MatiasV98/brazo-robotico-6gdl/cad/README.md

# cad

Modelos 3D del proyecto.

## Contenido

| Archivo | Descripción |
|---|---|
| `carcasa_electronica.f3d` | Diseño de la caja (carcasa) que protege la electrónica del brazo. |

La carcasa se imprimió en 3D en **PLA**, en una impresora Bambu Lab A1 del Laboratorio de Técnicas Digitales III. Una imagen del diseño está en [`docs/img/carcasa.jpg`](../docs/img/carcasa.jpg).

El archivo es un proyecto de **Autodesk Fusion 360** (`.f3d`). Para abrirlo: en Fusion 360, *Archivo → Abrir → Abrir desde mi equipo* y seleccionar el archivo.
