MatiasV98/brazo-robotico-6gdl/(list of files, cad)

Other CAD files:
cad/carcasa_electronica.f3d
