MatiasV98/brazo-robotico-6gdl/hardware/kicad/Placa Definitiva-Proyecto Brazo Robotico.kicad_pcb

## KiCad design hardware/kicad/Placa Definitiva-Proyecto Brazo Robotico.kicad_pcb (2026-11-07)

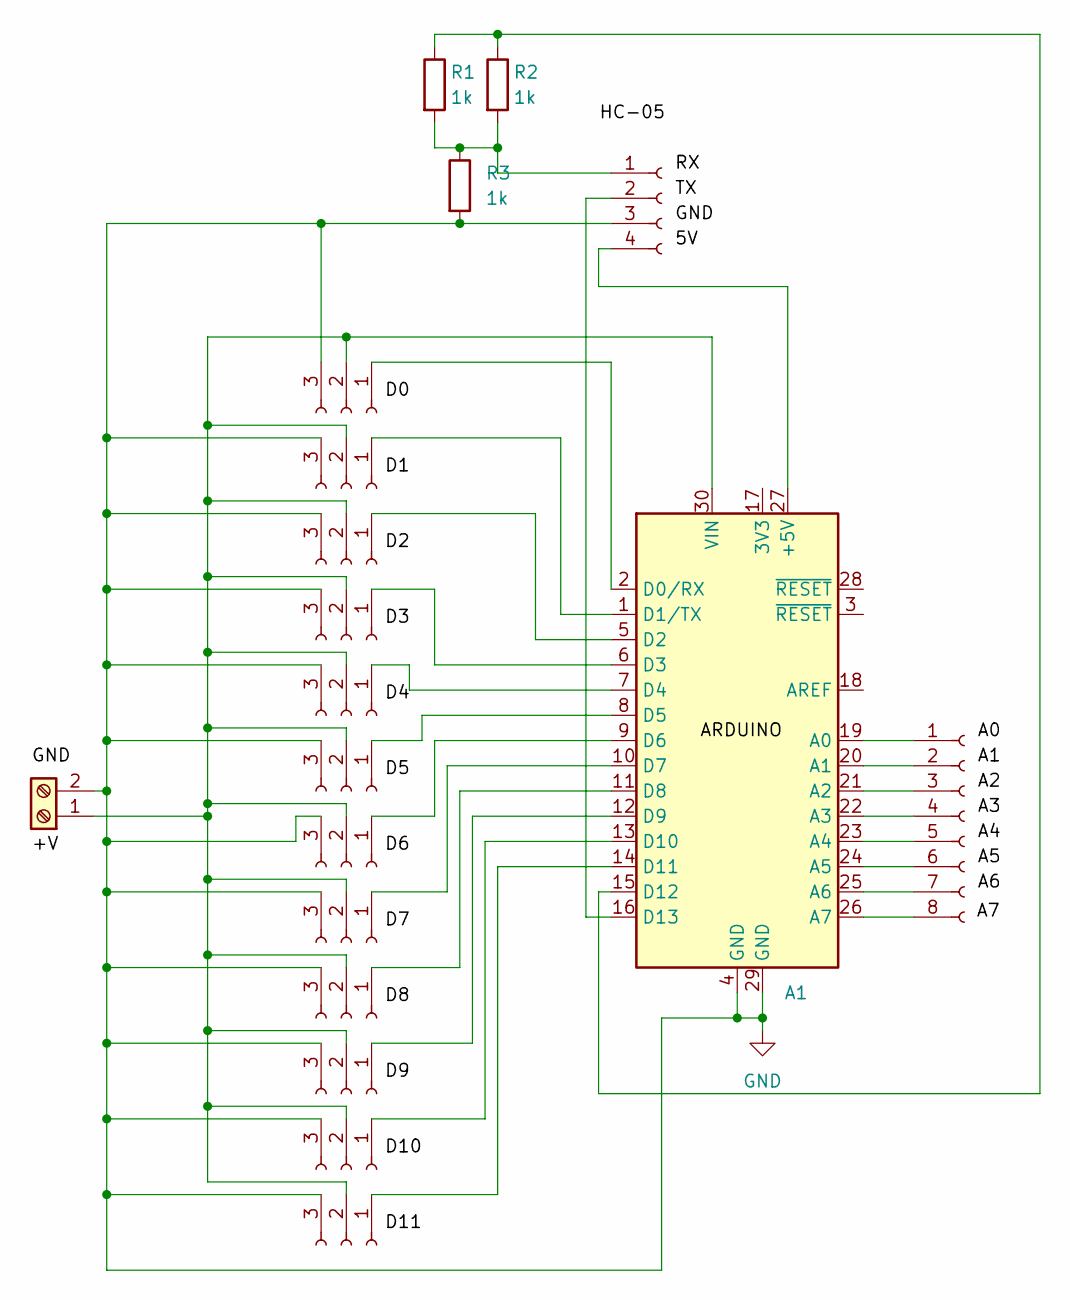
[picture p8: schematic Placa Definitiva-Proyecto Brazo Robotico.kicad_sch]

Parts:
A1: Arduino_Nano_v2.x; Arduino_Nano
J1: Screw_Terminal_01x02; TerminalBlock_MaiXu_MX126-5.0-02P_1x02_P5.00mm
J2: Conn_01x04_Socket; PinSocket_1x04_P2.54mm_Vertical
J6: Conn_01x08_Socket; PinSocket_1x08_P2.54mm_Vertical
J11, J12, J13, J14, J15, J16, J17, J18, J19, J20, J21, J22: Conn_01x03_Socket; PinSocket_1x03_P2.54mm_Vertical
R1, R2, R3: 1k; R_Axial_DIN0207_L6.3mm_D2.5mm_P10.16mm_Horizontal

Connections:
GND: A1.4 (GND), A1.29 (GND), J1.2, J2.3, J11.3, J12.3, J13.3, J14.3, J15.3, J16.3, J17.3, J18.3, J19.3, J20.3, J21.3, J22.3, R3.2
unnamed: A1.27 (+5V), J2.4
unnamed: A1.19 (A0), J6.1
unnamed: A1.20 (A1), J6.2
unnamed: A1.21 (A2), J6.3
unnamed: A1.22 (A3), J6.4
unnamed: A1.23 (A4), J6.5
unnamed: A1.24 (A5), J6.6
unnamed: A1.25 (A6), J6.7
unnamed: A1.26 (A7), J6.8
unnamed: A1.2 (D0/RX), J22.1
unnamed: A1.1 (D1/TX), J21.1
unnamed: A1.5 (D2), J20.1
unnamed: A1.6 (D3), J19.1
unnamed: A1.7 (D4), J18.1
unnamed: A1.8 (D5), J17.1
unnamed: A1.9 (D6), J15.1
unnamed: A1.10 (D7), J11.1
unnamed: A1.11 (D8), J12.1
unnamed: A1.12 (D9), J13.1
unnamed: A1.13 (D10), J14.1
unnamed: A1.14 (D11), J16.1
unnamed: A1.15 (D12), R1.1, R2.1
unnamed: A1.16 (D13), J2.2
unnamed: A1.30 (VIN), J1.1, J11.2, J12.2, J13.2, J14.2, J15.2, J16.2, J17.2, J18.2, J19.2, J20.2, J21.2, J22.2
unnamed: J2.1, R1.2, R2.2, R3.1

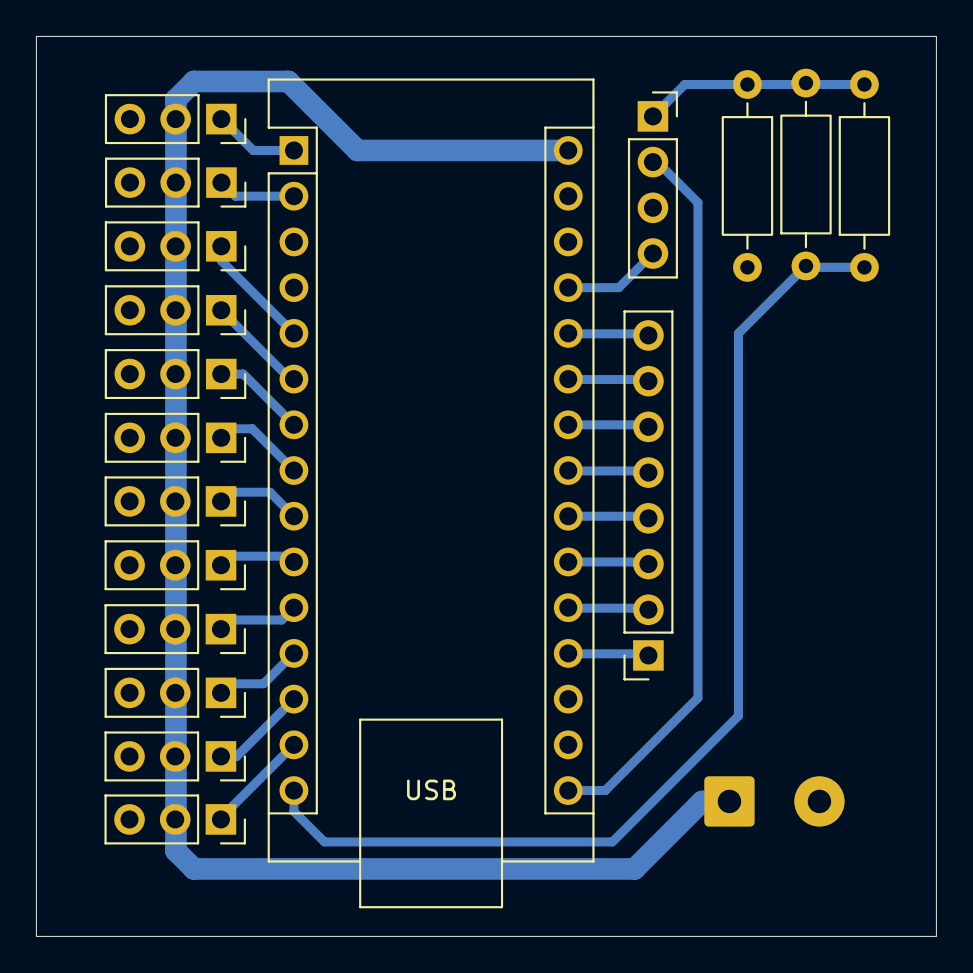
[picture p9: board Placa Definitiva-Proyecto Brazo Robotico.kicad_pcb from above]

Board: 2 copper layers, 50.0 x 50.0 mm, 19 parts (1 on the bottom side), 26 nets.
