MatiasV98/brazo-robotico-6gdl/(commit log)

2026-11-07 Add .gitignore for various development files
    Add common file patterns to ignore for Arduino, KiCad, CAD, OS, editors, and temporary files.
2026-11-07 Carcasa de la electrónica (Fusion 360)
    [CAJA ROBOT.f3d]
2026-11-07 Imágenes: brazo, esquemático, PCB y carcasa
2026-11-07 Documentación: manual técnico, limitaciones, materiales e índice
2026-11-07 Programa de prueba: Movimiento_Automatico_Un_Servo
2026-11-07 Programa de prueba: Movimiento_Automaticos_Todos_Servos
2026-11-07 Programa de prueba: Movimiento_Bluetooth_Todos_Servos
2026-11-07 Programa de prueba: Prueba_De_Limites
2026-11-07 Archivos de fabricación de la PCB (Gerber y taladrado)
    [Placa Definitiva-Proyecto Brazo Robotico-B_Cu.gbr, Placa Definitiva-Proyecto Brazo Robotico-B_Mask.gbr, Placa Definitiva-Proyecto Brazo Robotico-B_Paste.gbr, Placa Definitiva-Proyecto Brazo Robotico-B_Silkscreen.gbr, Placa Definitiva-Proyecto Brazo Robotico-Edge_Cuts.gbr, Placa Definitiva-Proyecto Brazo Robotico-F_Mask.gbr, Placa Definitiva-Proyecto Brazo Robotico-F_Paste.gbr, Placa Definitiva-Pr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]
2026-11-07 Proyecto de KiCad de la placa de control
    [Placa Definitiva-Proyecto Brazo Robotico.kicad_pcb, Placa Definitiva-Proyecto Brazo Robotico.kicad_sch]
2026-11-07 Índice de hardware
2026-11-07 Panel web de control (Web Serial por Bluetooth)
2026-11-07 Orden del repositorio: nombres de carpetas, manual en PDF, sin duplicados
    - Programas de firmware en carpetas planas con nombres que describen su
    contenido (version_anterior, prueba_limites, calibrador_servo_bt, ...).
    - hardware/kicad y hardware/fabricacion; carcasa como carcasa_electronica.f3d.
    - Se quita .kicad_prl (preferencias locales de KiCad) y se ignora en adelante.
    - Manual técnico en PDF para que se lea en GitHub.
    - El archivo de limitaciones aclara qué secciones son del firmware anterior.
    - firmware/README ya no repite la descripción del README principal.
    [Placa Definitiva-Proyecto Brazo Robotico-B_Cu.gbr, Placa Definitiva-Proyecto Brazo Robotico-B_Mask.gbr, Placa Definitiva-Proyecto Brazo Robotico-B_Paste.gbr, Placa Definitiva-Proyecto Brazo Robotico-B_Silkscreen.gbr, Placa Definitiva-Proyecto Brazo Robotico-Edge_Cuts.gbr, Placa Definitiva-Proyecto Brazo Robotico-F_Mask.gbr, Placa Definitiva-Proyecto Brazo Robotico-F_Paste.gbr, Placa Definitiva-Pr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]
